FedericoDiPasquale/tt_um_psei_ota_qboost/mag/main.sim.spice

* NGSPICE file created from main_parax.ext - technology: sky130A

.subckt main_parax VDD GND b0 b1 b2 out
X0 x5.XR6.R1 x5.XR10.R1 sky130_fd_pr__res_generic_po w=1 l=21
X1 x5.XR10.R1 x5.XR11.R2 sky130_fd_pr__res_generic_po w=1 l=21
X2 VDD.t15 x1.x3.XM4.G x1.XC1.C1 VDD.t14 sky130_fd_pr__pfet_01v8 ad=1.45 pd=10.58 as=1.45 ps=10.58 w=5 l=0.5
X3 VDD.t9 VDD.t8 GND.t29 GND.t28 sky130_fd_pr__nfet_01v8 ad=1.16 pd=8.58 as=1.16 ps=8.58 w=4 l=0.5
X4 x1.XC1.C1 GND.t15 sky130_fd_pr__cap_mim_m3_1 l=30 w=30
X5 x1.x3.XM4.G x1.x4.VINN x1.x3.XM5.S GND.t3 sky130_fd_pr__nfet_01v8 ad=0.58 pd=4.58 as=0.58 ps=4.58 w=2 l=0.5
X6 out.t0 x1.x4.VINN x1.x4.XM5.S GND.t4 sky130_fd_pr__nfet_01v8 ad=0.145 pd=1.58 as=0.145 ps=1.58 w=0.5 l=7
X7 VDD.t7 VDD.t6 GND.t25 GND.t24 sky130_fd_pr__nfet_01v8 ad=0.29 pd=2.58 as=0.29 ps=2.58 w=1 l=0.5
X8 x5.out GND.t12 sky130_fd_pr__res_generic_po w=1 l=21
X9 x1.x1.XM5.S VDD.t28 GND.t21 GND.t20 sky130_fd_pr__nfet_01v8 ad=1.16 pd=8.58 as=1.16 ps=8.58 w=4 l=1.48
X10 b2.t0 x5.XR8.R1 sky130_fd_pr__res_generic_po w=1 l=21
X11 x1.x2.XM5.S VDD.t27 GND.t31 GND.t30 sky130_fd_pr__nfet_01v8 ad=1.16 pd=8.58 as=1.16 ps=8.58 w=4 l=1.48
X12 x1.x4.XM4.G out.t6 x1.x4.XM5.S GND.t9 sky130_fd_pr__nfet_01v8 ad=0.145 pd=1.58 as=0.145 ps=1.58 w=0.5 l=7
X13 x1.XC1.C1 GND.t16 sky130_fd_pr__cap_mim_m3_1 l=30 w=30
X14 x1.x1.XM4.G x1.x4.VINN x1.x1.XM5.S GND.t5 sky130_fd_pr__nfet_01v8 ad=0.58 pd=4.58 as=0.58 ps=4.58 w=2 l=0.5
X15 x1.x4.XM5.S VDD.t26 GND.t33 GND.t32 sky130_fd_pr__nfet_01v8 ad=0.145 pd=1.58 as=0.145 ps=1.58 w=0.5 l=20
X16 VDD.t19 x1.x2.XM4.G x1.x2.XM4.G VDD.t18 sky130_fd_pr__pfet_01v8 ad=1.45 pd=10.58 as=1.45 ps=10.58 w=5 l=0.5
X17 VDD.t21 x1.x2.XM4.G out.t3 VDD.t20 sky130_fd_pr__pfet_01v8 ad=1.45 pd=10.58 as=1.45 ps=10.58 w=5 l=0.5
X18 x1.XC1.C1 GND.t17 sky130_fd_pr__cap_mim_m3_1 l=30 w=30
X19 VDD.t3 x1.x4.XM4.G out.t2 VDD.t2 sky130_fd_pr__pfet_01v8 ad=0.29 pd=2.58 as=0.29 ps=2.58 w=1 l=7
X20 x5.out x5.XR11.R2 sky130_fd_pr__res_generic_po w=1 l=63
X21 VDD.t11 VDD.t10 GND.t27 GND.t26 sky130_fd_pr__nfet_01v8 ad=1.16 pd=8.58 as=1.16 ps=8.58 w=4 l=0.5
X22 VDD.t13 VDD.t12 GND.t23 GND.t22 sky130_fd_pr__nfet_01v8 ad=1.16 pd=8.58 as=1.16 ps=8.58 w=4 l=0.5
X23 VDD.t5 x1.x4.XM4.G x1.x4.XM4.G VDD.t4 sky130_fd_pr__pfet_01v8 ad=0.29 pd=2.58 as=0.29 ps=2.58 w=1 l=7
X24 x5.XR4.R2 x5.XR9.R2 sky130_fd_pr__res_generic_po w=1 l=21
X25 x1.x3.XM5.S VDD.t29 GND.t19 GND.t18 sky130_fd_pr__nfet_01v8 ad=1.16 pd=8.58 as=1.16 ps=8.58 w=4 l=1.48
X26 out.t5 GND.t10 sky130_fd_pr__cap_mim_m3_1 l=24 w=24
X27 x1.XC1.C1 x5.out x1.x1.XM5.S GND.t34 sky130_fd_pr__nfet_01v8 ad=0.58 pd=4.58 as=0.58 ps=4.58 w=2 l=0.5
X28 x5.XR2.R1 x5.XR9.R2 sky130_fd_pr__res_generic_po w=1 l=21
X29 b1.t0 x5.XR6.R1 sky130_fd_pr__res_generic_po w=1 l=21
X30 b0.t0 x5.XR4.R2 sky130_fd_pr__res_generic_po w=1 l=21
X31 out.t1 x1.x4.VINN x1.x2.XM5.S GND.t6 sky130_fd_pr__nfet_01v8 ad=0.58 pd=4.58 as=0.58 ps=4.58 w=2 l=0.5
X32 VDD.t0 x1.x4.VINN GND.t7 sky130_fd_pr__res_high_po_1p41 l=88.83
X33 x1.XC1.C1 out.t7 x1.x3.XM5.S GND.t8 sky130_fd_pr__nfet_01v8 ad=0.58 pd=4.58 as=0.58 ps=4.58 w=2 l=0.5
X34 GND.t0 x5.XR2.R1 sky130_fd_pr__res_generic_po w=1 l=21
X35 x5.XR9.R2 x5.XR10.R1 sky130_fd_pr__res_generic_po w=1 l=21
X36 x1.XC1.C1 GND.t14 sky130_fd_pr__cap_mim_m3_1 l=30 w=30
X37 VDD.t1 x5.out sky130_fd_pr__res_generic_po w=1 l=21
X38 GND.t2 x1.x4.VINN GND.t1 sky130_fd_pr__res_high_po_1p41 l=88.83
X39 VDD.t17 x1.x3.XM4.G x1.x3.XM4.G VDD.t16 sky130_fd_pr__pfet_01v8 ad=1.45 pd=10.58 as=1.45 ps=10.58 w=5 l=0.5
X40 VDD.t25 x1.x1.XM4.G x1.x1.XM4.G VDD.t24 sky130_fd_pr__pfet_01v8 ad=1.45 pd=10.58 as=1.45 ps=10.58 w=5 l=0.5
X41 VDD.t23 x1.x1.XM4.G x1.XC1.C1 VDD.t22 sky130_fd_pr__pfet_01v8 ad=1.45 pd=10.58 as=1.45 ps=10.58 w=5 l=0.5
X42 x5.XR8.R1 x5.XR11.R2 sky130_fd_pr__res_generic_po w=1 l=21
X43 x1.x2.XM4.G x1.XC1.C1 x1.x2.XM5.S GND.t13 sky130_fd_pr__nfet_01v8 ad=0.58 pd=4.58 as=0.58 ps=4.58 w=2 l=0.5
X44 out.t4 GND.t11 sky130_fd_pr__cap_mim_m3_1 l=24 w=24
R0 out out.t7 285.474
R1 out.t7 out 274.911
R2 out out.t2 223.565
R3 out out.t0 219.8
R4 out out.t3 47.4992
R5 out out.t1 39.5338
R6 out.n5 out.n4 22.2846
R7 out.n3 out 19.8925
R8 out.n6 out.n5 16.6486
R9 out.n0 out 14.1405
R10 out.n1 out 13.5479
R11 out.n4 out 11.2789
R12 out out.t6 11.2155
R13 out.n0 out 9.52394
R14 out.n2 out 6.77178
R15 out out.n6 6.20016
R16 out out.n0 5.92238
R17 out out.n2 5.82436
R18 out.n1 out 5.67664
R19 out.n2 out 5.58145
R20 out.n4 out.n3 4.5005
R21 out.n5 out.n1 3.86414
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
R902 GND.n365 GND.n19 7.8005
R903 GND.n38 GND.n35 7.8005
R904 GND.n42 GND.n35 7.8005
R905 GND.n41 GND.n40 7.8005
R906 GND.n42 GND.n41 7.8005
R907 GND.n369 GND.n25 7.8005
R908 GND.n369 GND.n17 7.8005
R909 GND.n27 GND.n26 7.8005
R910 GND.n27 GND.n17 7.8005
R911 GND.n337 GND.n333 7.8005
R912 GND.n354 GND.n333 7.8005
R913 GND.n353 GND.n352 7.8005
R914 GND.n354 GND.n353 7.8005
R915 GND.n347 GND.n346 7.8005
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
